nekrutnikolai/Consolometer/README.md

# The Arduino Consolometer

An Arduino-powered device that can function as both a thermometer and game console!
- [Documentation](/Arduino_Consolometer.pdf)
- [Here's a stop-motion film that I made about it](https://www.youtube.com/watch?v=Srl9ST27SpA)
