nekrutnikolai/Consolometer/Sensor Protector.stl

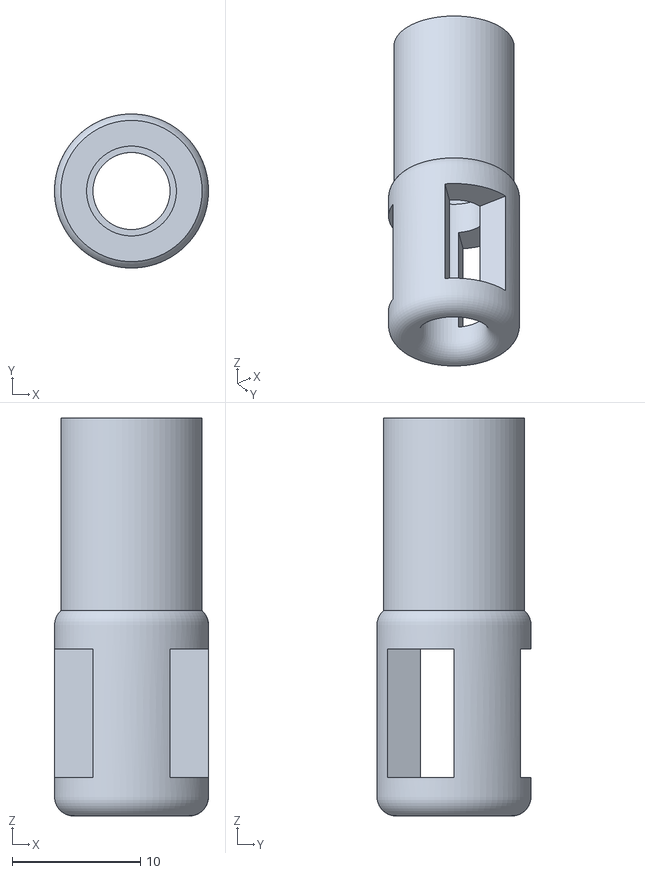
[picture p10: CAD file, 2020-12-27]
Sensor Protector.stl
12.0 x 12.0 x 31.0
