nekrutnikolai/Consolometer/ConsolometerBase.stl

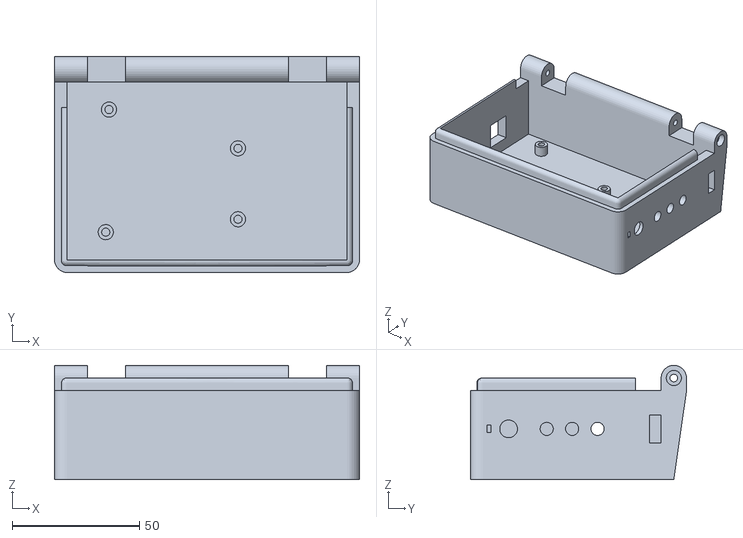
[picture p11: CAD file, 2020-12-27]
ConsolometerBase.stl
120.0 x 85.0 x 45.0
