nekrutnikolai/Consolometer/ConsolometerLid.stl

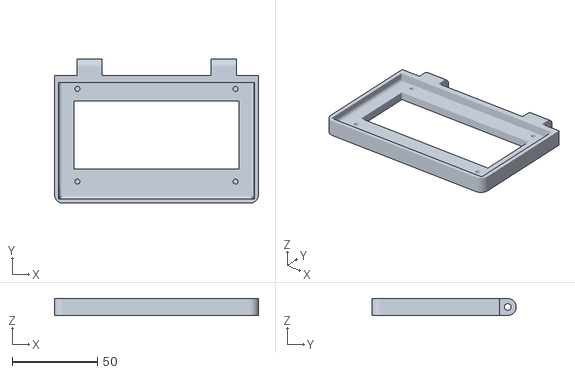
[picture p12: CAD file, 2020-12-27]
ConsolometerLid.stl
120.0 x 85.0 x 10.0
