nekrutnikolai/Consolometer/(list of files, cad)

Other CAD files:
ConsolometerBase.f3d
ConsolometerLid.f3d
Sensor Protector.f3d
