nekrutnikolai/Consolometer/(commit log)

2020-12-27 Added Arduino box and LCD lid CAD files
    [Detector Building Arduino & LCD Base V2.stl, Detector Building LCD Cover.stl]
2020-12-27 Added CAD files
    [ConsolometerBase.f3d, ConsolometerBase.stl, ConsolometerLid.f3d, ConsolometerLid.stl, Sensor Protector.f3d, Sensor Protector.stl]
